robmauridemil-pixel/SCALL/arduino_uno/esquematico_arduino_uno.png

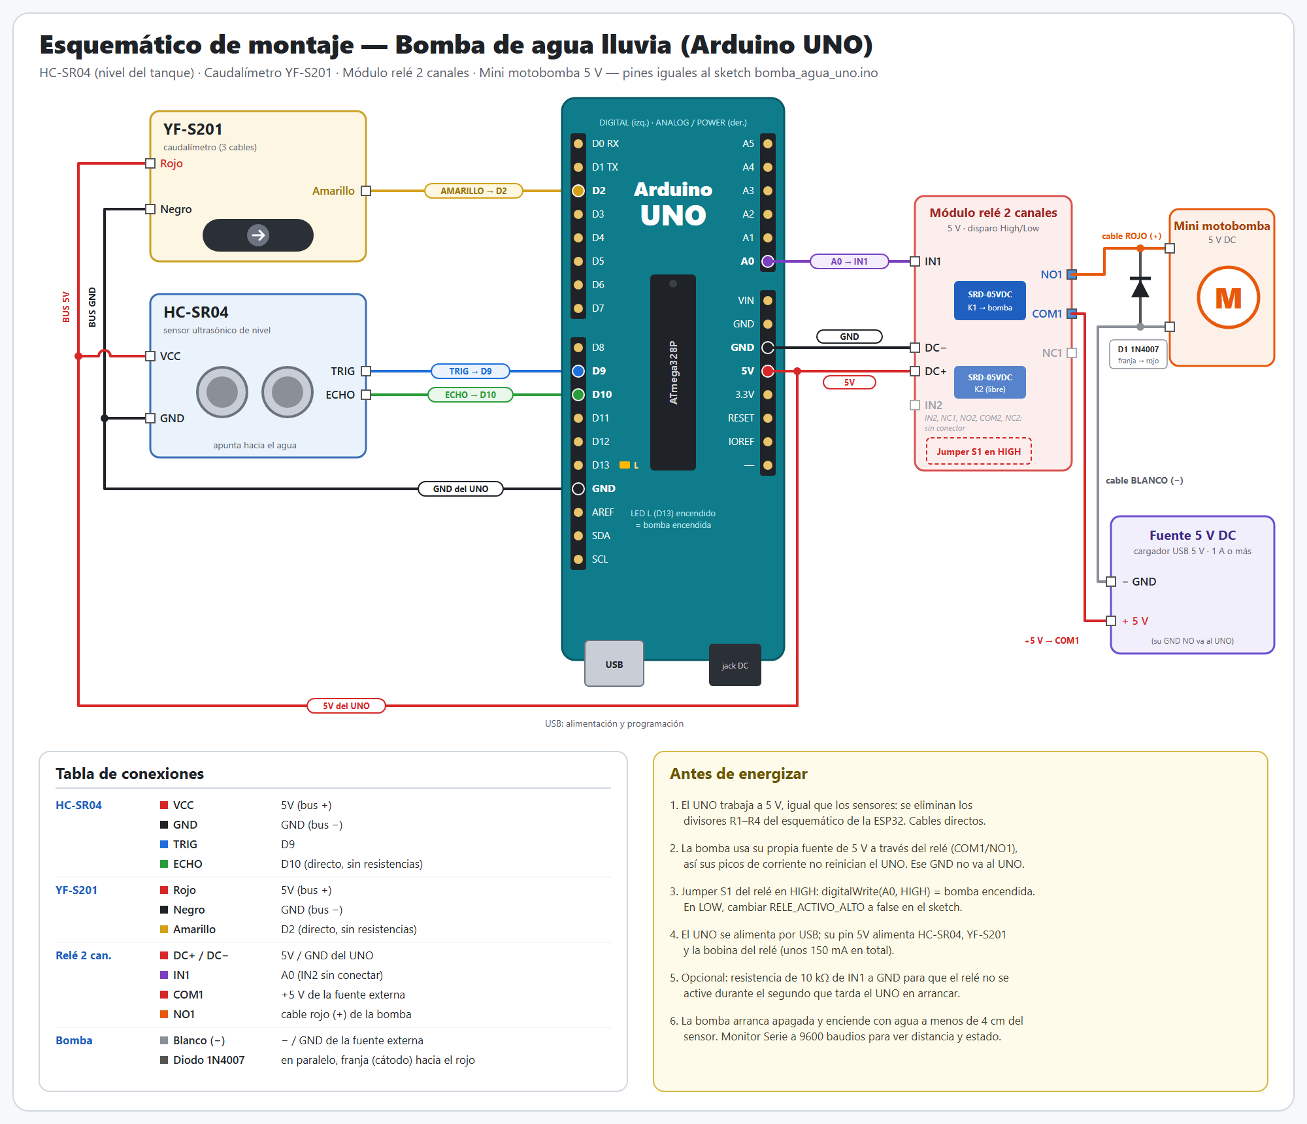
arduino_uno/esquematico_arduino_uno.png
