robmauridemil-pixel/SCALL/assets/scall-mark.png

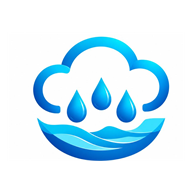
assets/scall-mark.png
