robmauridemil-pixel/SCALL/esquematico_bomba_esp32s3_rele2canales.png

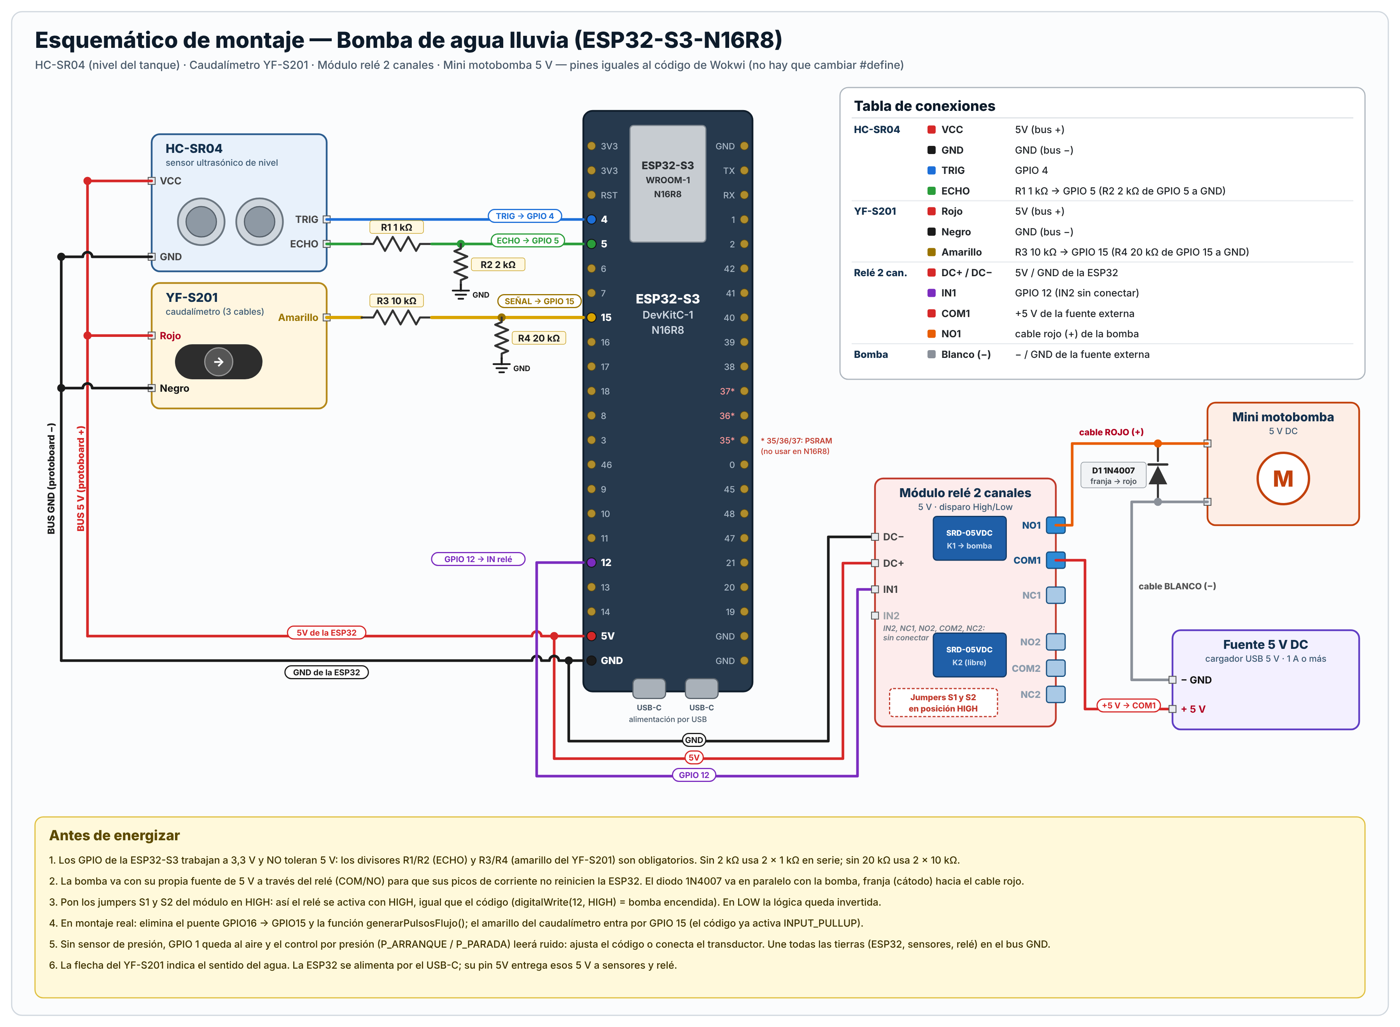
esquematico_bomba_esp32s3_rele2canales.png
