robmauridemil-pixel/SCALL/info/Paleta de colores.jpeg

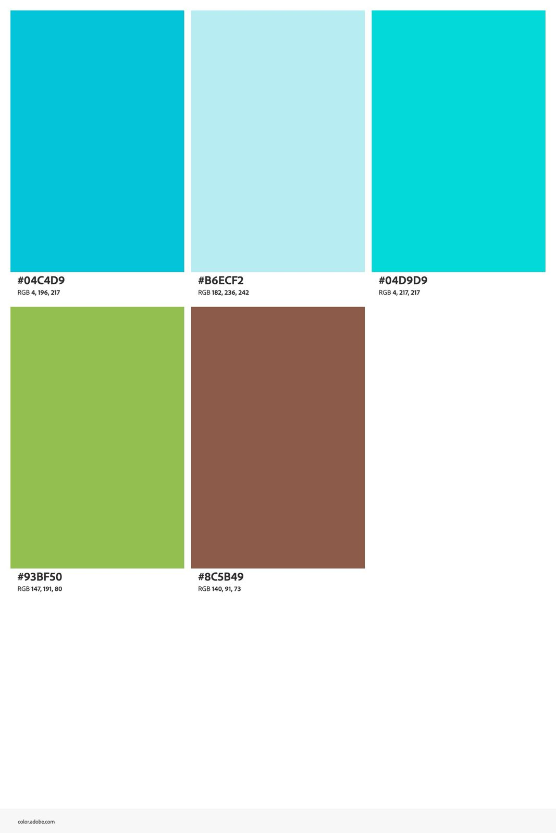
info/Paleta de colores.jpeg
