robmauridemil-pixel/SCALL/(commit log)

2026-10-27 feat: add SCALL rain-water pump firmware and monitoring panel
    Pump runs only while water is within 4 cm of the HC-SR04 (off at 4.5 cm,
    0.5 cm band for sensor noise). Dry-run protection is opt-in because the
    YF-S201 floor (~1 L/min) can falsely latch a 5 V mini pump.
    [bomba_agua_esp32s3_2.ino]
2026-10-27 refactor: move ESP32 sketch into its Arduino sketch folder
2026-10-27 feat: add Arduino UNO firmware and wiring diagram
    UNO runs at 5 V, so the ESP32 voltage dividers are dropped. Relay IN1
    moves to A0 for a crossing-free diagram and defaults to active-LOW to
    match the single-channel SRD-05VDC-SL-C module.
2026-10-27 fix: open panel in simulation mode with 4/4.5 cm thresholds
    The UNO build has no WiFi, so the deployed panel would wait forever for
    telemetry. The demo model still used the old 7 cm off threshold, and the
    ON/OFF rail labels overlapped at 0.5 cm apart.
